Xevel/usb2ax_pro/README.md

# usb2ax_pro
Fast USB interface for robotics servos (Dynamixel)

## License
Code is under MIT License.
