Xevel/usb2ax_pro/elec/usb2ax_pro_main_v1.0.brd

## EAGLE design elec/usb2ax_pro_main_v1.0.brd (2016-09-20)

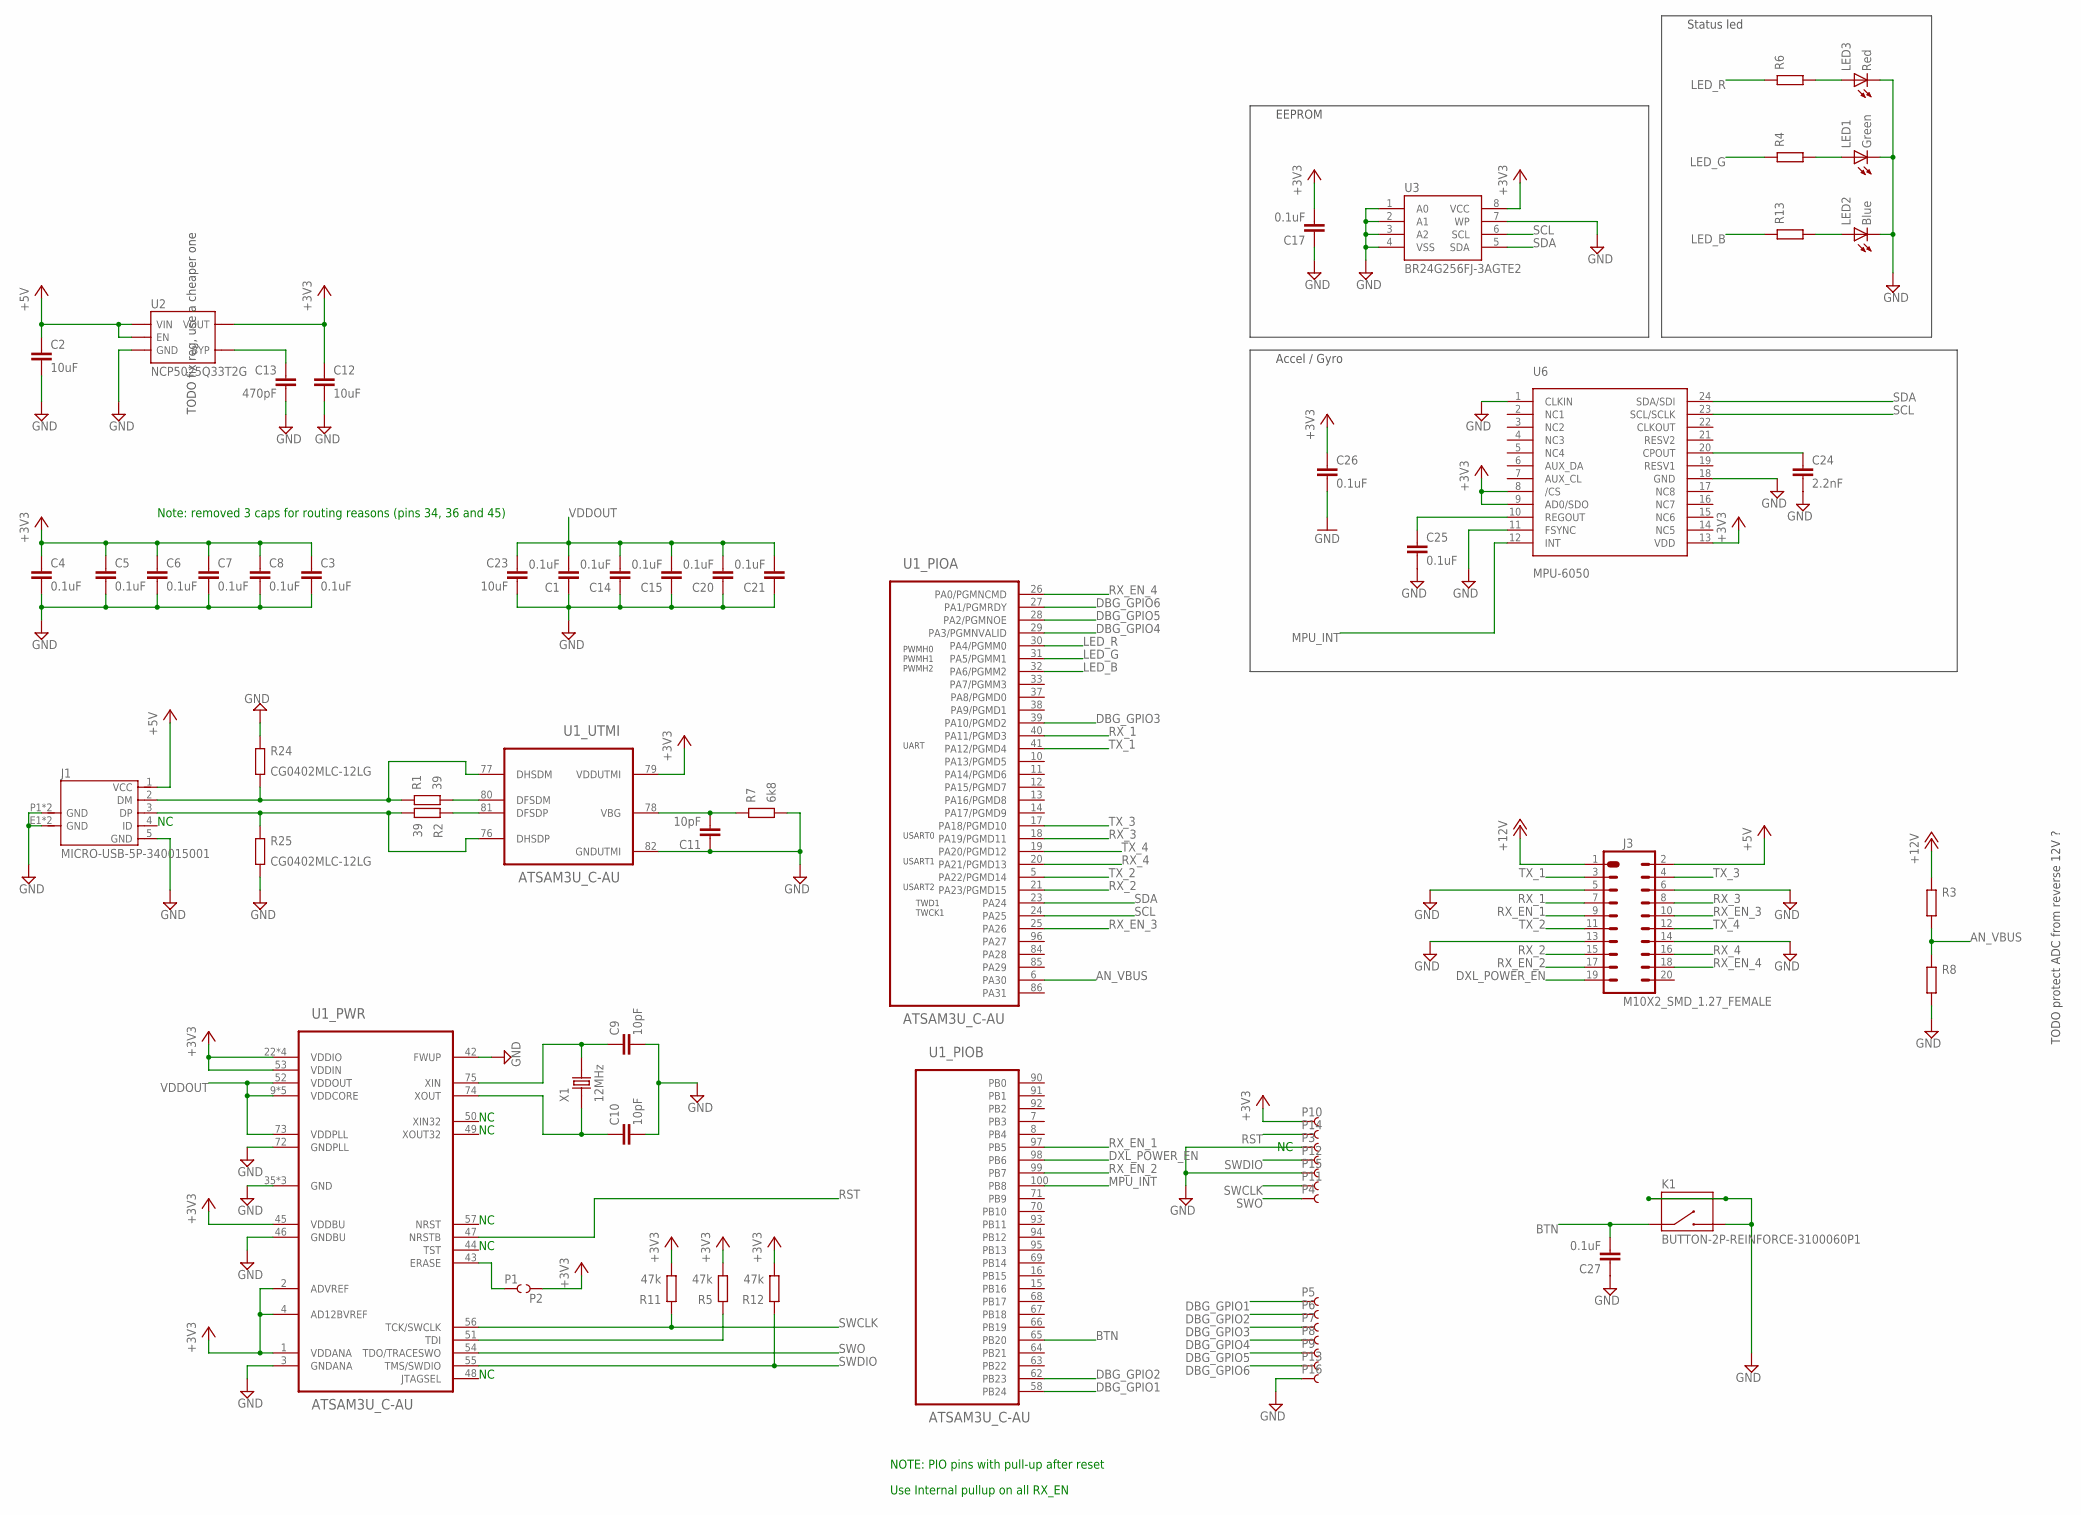
[picture p1: schematic usb2ax_pro_main_v1.0.sch]

Parts:
C1, C3, C4, C5, C6, C7, C8, C14, C15, C17, C20, C21, C25, C26, C27: 0.1uF; 0201_N
C2, C12, C23: 10uF; 0805_N
C9, C10, C11: 10pF; 0201_N
C13: 470pF; 0201_N
C24: 2.2nF; 0201_N
J1: MICRO-USB-5P-340015001; B-SMD-5P
J3: M10X2_SMD_1.27_FEMALE; 2X10_SMD_1.27_FEMALE
K1: BUTTON-2P-REINFORCE-3100060P1; 4P-SMD-7.0X3.5X3.5H-90D
LED1: Green; D_0603_N
LED2: Blue; D_0603_N
LED3: Red; D_0603_N
P1, P2: PIN_SMD_2X2.5
P3, P4, P10, P11, P12, P14, P15: PIN_SMD_0.8X1.6
P5, P6, P7, P8, P9, P13, P16: PIN_SMD_1X2
R1, R2: 39; 0201_N
R3, R4, R6, R8, R13: R0201; 0201_N
R5, R11, R12: 47k; 0201_N
R7: 6k8; 0201_N
R24, R25: CG0402MLC-12LG; 0402_N
U1: ATSAM3U_C-AU; QFP50P1600X1600-100N
U2: NCP5025Q33T2G; SC70-5
U3: BR24G256FJ-3AGTE2; SO08
U6: MPU-6050; QFN-24
X1: 12MHz; 2P-SMD-5.0X3.2

Connections:
+3V3: C3.1, C4.1, C5.1, C6.1, C7.1, C8.1, C12.1, C17.2, C26.1, P2.PIN, P10.PIN, R5.1, R11.1, R12.1, U1.1 (VDDANA), U1.2 (ADVREF), U1.4 (AD12BVREF), U1.22 (VDDIO), U1.36 (VDDIO), U1.45 (VDDBU), U1.53 (VDDIN), U1.60 (VDDIO), U1.79 (VDDUTMI), U1.88 (VDDIO), U2.5 (VOUT), U3.8 (VCC), U6.8 (/CS), U6.9 (AD0/SDO), U6.13 (VDD)
+5V: C2.1, J1.1 (VCC), J3.2, U2.1 (VIN), U2.3 (EN)
+12V: J3.1, R3.2
AN_VBUS: R3.1, R8.2, U1.6 (PA30)
BTN: C27.2, K1.1, U1.65 (PB20)
DBG_GPIO1: P5.P$1, U1.58 (PB24)
DBG_GPIO2: P6.P$1, U1.62 (PB23)
DBG_GPIO3: P7.P$1, U1.39 (PA10/PGMD2)
DBG_GPIO4: P8.P$1, U1.29 (PA3/PGMNVALID)
DBG_GPIO5: P9.P$1, U1.28 (PA2/PGMNOE)
DBG_GPIO6: P13.P$1, U1.27 (PA1/PGMRDY)
DXL_POWER_EN: J3.19, U1.98 (PB6)
GND: C1.1, C2.2, C3.2, C4.2, C5.2, C6.2, C7.2, C8.2, C9.2, C10.2, C11.1, C12.2, C13.2, C14.1, C15.1, C17.1, C20.1, C21.1, C23.2, C24.2, C25.2, C26.2, C27.1, J1.5 (GND), J1.E1 (GND), J1.E2 (GND), J1.P1 (GND), J1.P2 (GND), J3.5, J3.6, J3.13, J3.14, K1.2, K1.S1, K1.S2, LED1.C, LED2.C, LED3.C, P3.PIN, P15.PIN, P16.P$1, R7.1, R8.1, R24.2, R25.1, U1.3 (GNDANA), U1.35 (GND), U1.42 (FWUP), U1.46 (GNDBU), U1.61 (GND), U1.72 (GNDPLL), U1.82 (GNDUTMI), U1.89 (GND), U2.2 (GND), U3.1 (A0), U3.2 (A1), U3.3 (A2), U3.4 (VSS), U3.7 (WP), U6.1 (CLKIN), U6.11 (FSYNC), U6.18 (GND)
LED_B: R13.2, U1.32 (PA6/PGMM2)
LED_G: R4.2, U1.31 (PA5/PGMM1)
LED_R: R6.2, U1.30 (PA4/PGMM0)
MPU_INT: U1.100 (PB8), U6.12 (INT)
unnamed: J1.2 (DM), R1.2, R24.1, U1.77 (DHSDM)
unnamed: J1.3 (DP), R2.1, R25.2, U1.76 (DHSDP)
unnamed: R2.2, U1.81 (DFSDP)
unnamed: R1.1, U1.80 (DFSDM)
unnamed: LED3.A, R6.1
unnamed: LED2.A, R13.1
unnamed: LED1.A, R4.1
unnamed: C9.1, U1.75 (XIN), X1.2
unnamed: C10.1, U1.74 (XOUT), X1.1
unnamed: P1.PIN, U1.43 (ERASE)
unnamed: C13.1, U2.4 (BYP)
unnamed: C11.2, R7.2, U1.78 (VBG)
unnamed: C25.1, U6.10 (REGOUT)
unnamed: C24.1, U6.20 (CPOUT)
RST: P14.PIN, U1.47 (NRSTB)
RX_1: J3.7, U1.40 (PA11/PGMD3)
RX_2: J3.15, U1.21 (PA23/PGMD15)
RX_3: J3.8, U1.18 (PA19/PGMD11)
RX_4: J3.16, U1.20 (PA21/PGMD13)
RX_EN_1: J3.9, U1.97 (PB5)
RX_EN_2: J3.17, U1.99 (PB7)
RX_EN_3: J3.10, U1.25 (PA26)
RX_EN_4: J3.18, U1.26 (PA0/PGMNCMD)
SCL: U1.24 (PA25), U3.6 (SCL), U6.23 (SCL/SCLK)
SDA: U1.23 (PA24), U3.5 (SDA), U6.24 (SDA/SDI)
SWCLK: P11.PIN, R11.2, U1.56 (TCK/SWCLK)
SWDIO: P12.PIN, R12.2, U1.55 (TMS/SWDIO)
SWO: P4.PIN, U1.54 (TDO/TRACESWO)
TDI: R5.2, U1.51 (TDI)
TX_1: J3.3, U1.41 (PA12/PGMD4)
TX_2: J3.11, U1.5 (PA22/PGMD14)
TX_3: J3.4, U1.17 (PA18/PGMD10)
TX_4: J3.12, U1.19 (PA20/PGMD12)
VDDOUT: C1.2, C14.2, C15.2, C20.2, C21.2, C23.1, U1.9 (VDDCORE), U1.34 (VDDCORE), U1.52 (VDDOUT), U1.59 (VDDCORE), U1.73 (VDDPLL), U1.83 (VDDCORE), U1.87 (VDDCORE)

Notes on the sheet:
NOTE: PIO pins with pull-up after reset
Status led
Use Internal pullup on all RX_EN
EEPROM
Accel / Gyro
UART
USART0
USART1
USART2
TODO protect ADC from reverse 12V ?
Note: removed 3 caps for routing reasons (pins 34, 36 and 45)
PWMH0 PWMH1 PWMH2
TWD1 TWCK1
TODO fix reg, use a cheaper one

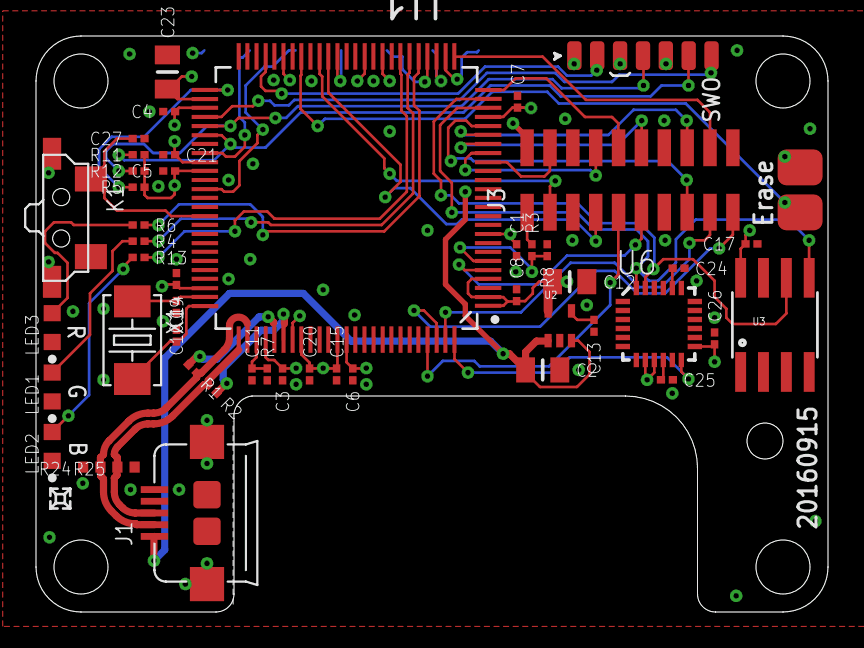
[picture p2: board usb2ax_pro_main_v1.0.brd from above]

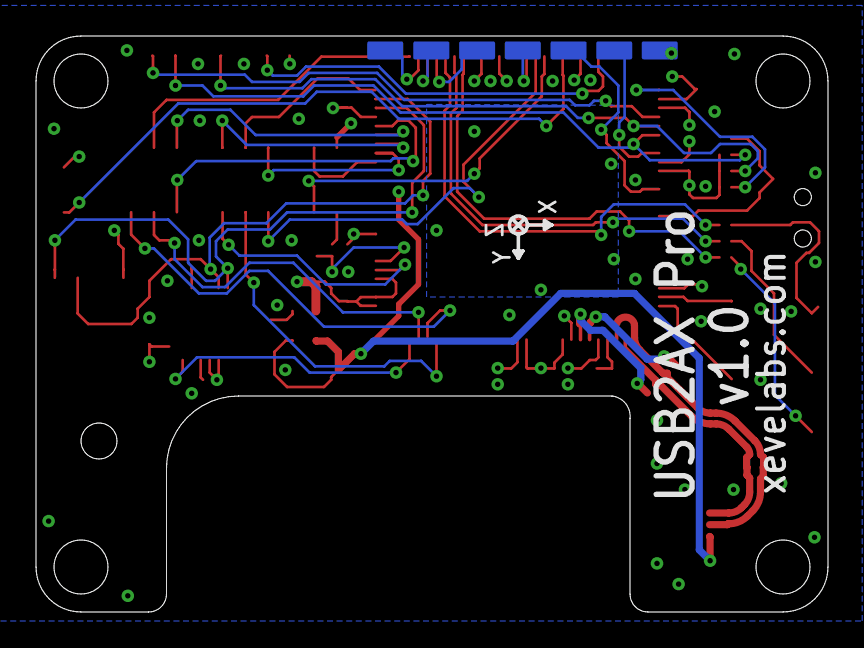
[picture p3: board usb2ax_pro_main_v1.0.brd from below]

Board: 4 copper layers, 44.0 x 32.0 mm, 64 parts (7 on the bottom side), 51 nets.

Other parts of the board:
U$3: XEVELABS_LOGO_S
