Xevel/usb2ax_pro/elec/usb2ax_pro_top_TTL_v1.0.brd

## EAGLE design elec/usb2ax_pro_top_TTL_v1.0.brd (2016-09-20)

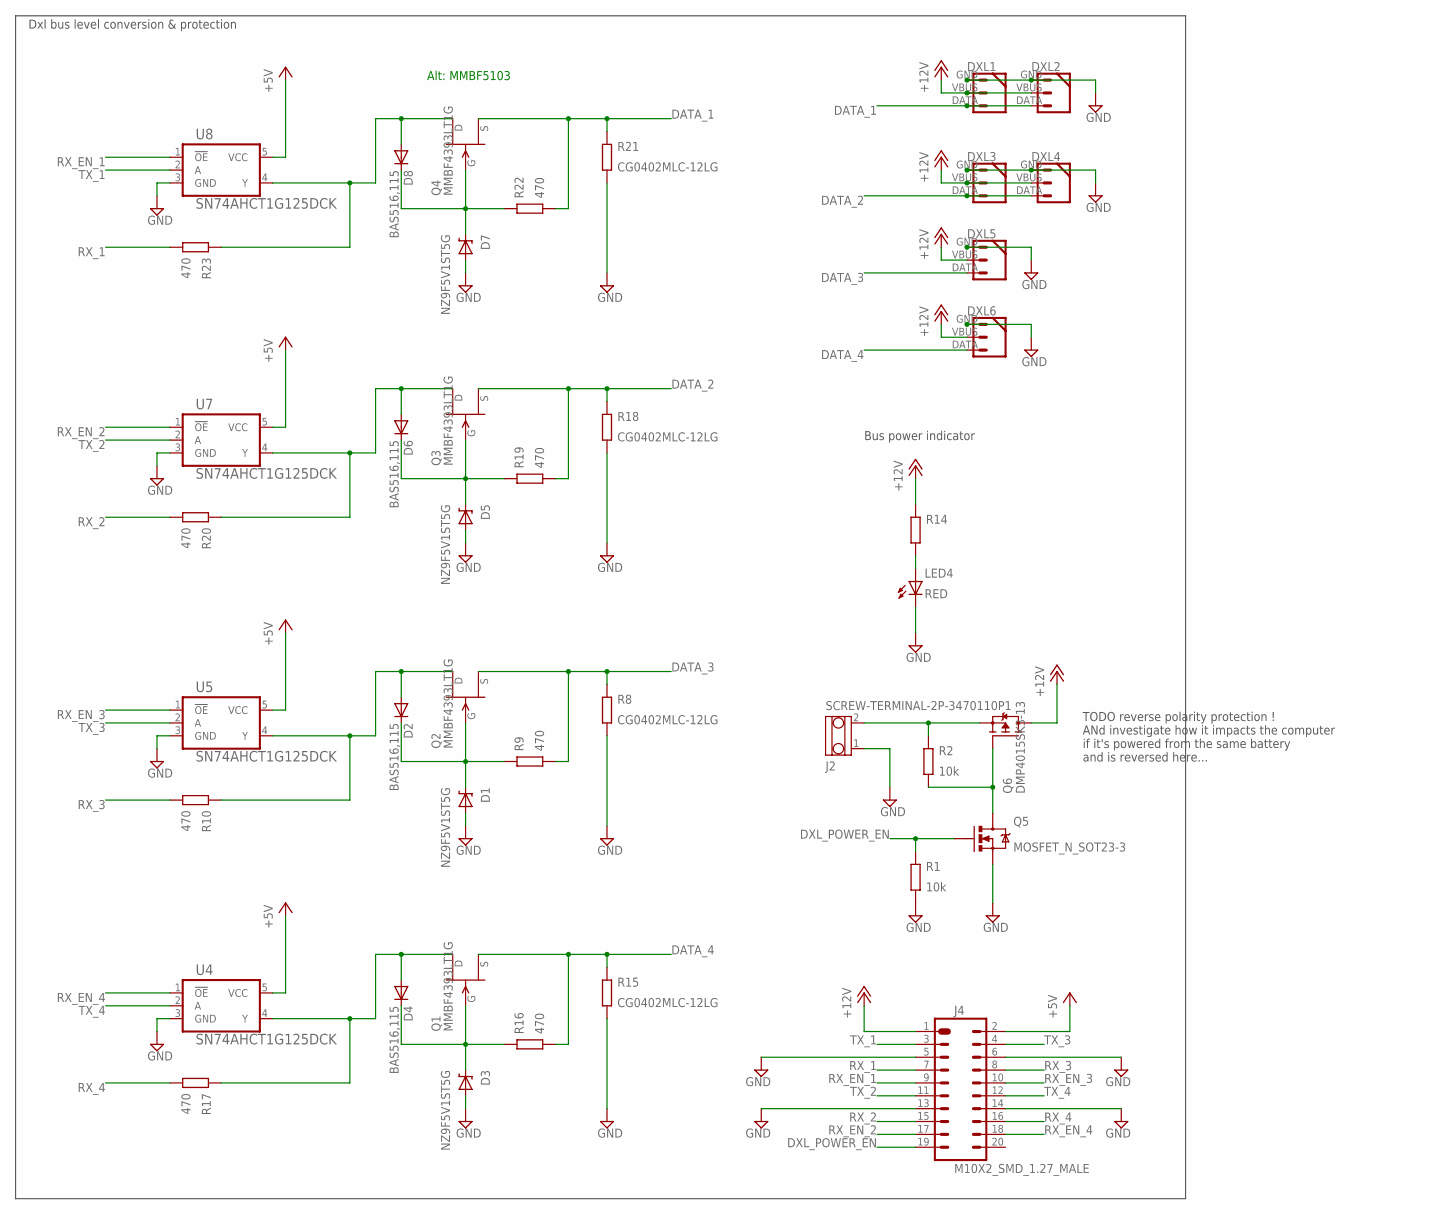
[picture p4: schematic usb2ax_pro_top_TTL_v1.0.sch]

Parts:
D1, D3, D5, D7: NZ9F5V1ST5G; SOD-923_N
D2, D4, D6, D8: BAS516,115; SOD523
DXL1, DXL2, DXL3, DXL4, DXL5, DXL6: DYNAMIXEL_3POS-R; DYNAMIXEL_3POS_RIGHT
J2: SCREW-TERMINAL-2P-3470110P1; 2P-5.0
J4: M10X2_SMD_1.27_MALE; 2X10_SMD_1.27_MALE
LED4: RED; D_0603_N
Q1, Q2, Q3, Q4: MMBF4393LT1G; SOT-23-3_L/SSOT-3_L
Q5: MOSFET_N_SOT23-3; SOT-23-3_N/SSOT-3_N
Q6: DMP4015SK3-13; TO252
R1, R2: 10k; 0402_N
R8, R15, R18, R21: CG0402MLC-12LG; 0402_N
R9, R10, R16, R17, R19, R20, R22, R23: 470; 0402_N
R14: R0402; 0402_N
U4, U5, U7, U8: SN74AHCT1G125DCK; SC70-5

Connections:
+5V: J4.2, U4.5 (VCC), U5.5 (VCC), U7.5 (VCC), U8.5 (VCC)
+12V: DXL1.VBUS (2), DXL2.VBUS (2), DXL3.VBUS (2), DXL4.VBUS (2), DXL5.VBUS (2), DXL6.VBUS (2), J4.1, Q6.3 (D), R14.2
DATA_1: DXL1.DATA (3), DXL2.DATA (3), Q4.2 (S), R21.2, R22.1
DATA_2: DXL3.DATA (3), DXL4.DATA (3), Q3.2 (S), R18.2, R19.1
DATA_3: DXL5.DATA (3), Q2.2 (S), R8.2, R9.1
DATA_4: DXL6.DATA (3), Q1.2 (S), R15.2, R16.1
DXL_POWER_EN: J4.19, Q5.1 (G), R1.2
GND: D1.A, D3.A, D5.A, D7.A, DXL1.GND (1), DXL2.GND (1), DXL3.GND (1), DXL4.GND (1), DXL5.GND (1), DXL6.GND (1), J2.1, J4.5, J4.6, J4.13, J4.14, LED4.C, Q5.2 (S), R1.1, R8.1, R15.1, R18.1, R21.1, U4.3 (GND), U5.3 (GND), U7.3 (GND), U8.3 (GND)
unnamed: Q5.3 (D), Q6.1 (G), R2.1
unnamed: D3.C, D4.C, Q1.3 (G), R16.2
unnamed: D1.C, D2.C, Q2.3 (G), R9.2
unnamed: D2.A, Q2.1 (D), R10.2, U5.4 (Y)
unnamed: LED4.A, R14.1
unnamed: D4.A, Q1.1 (D), R17.2, U4.4 (Y)
unnamed: D5.C, D6.C, Q3.3 (G), R19.2
unnamed: D6.A, Q3.1 (D), R20.2, U7.4 (Y)
unnamed: D7.C, D8.C, Q4.3 (G), R22.2
unnamed: J2.2, Q6.2 (S), R2.2
unnamed: D8.A, Q4.1 (D), R23.2, U8.4 (Y)
RX_1: J4.7, R23.1
RX_2: J4.15, R20.1
RX_3: J4.8, R10.1
RX_4: J4.16, R17.1
RX_EN_1: J4.9, U8.1 (!OE)
RX_EN_2: J4.17, U7.1 (!OE)
RX_EN_3: J4.10, U5.1 (!OE)
RX_EN_4: J4.18, U4.1 (!OE)
TX_1: J4.3, U8.2 (A)
TX_2: J4.11, U7.2 (A)
TX_3: J4.4, U5.2 (A)
TX_4: J4.12, U4.2 (A)

Notes on the sheet:
Dxl bus level conversion & protection
Alt: MMBF5103
TODO reverse polarity protection ! ANd investigate how it impacts the computer if it's powered from the same battery and is reversed here...
Bus power indicator

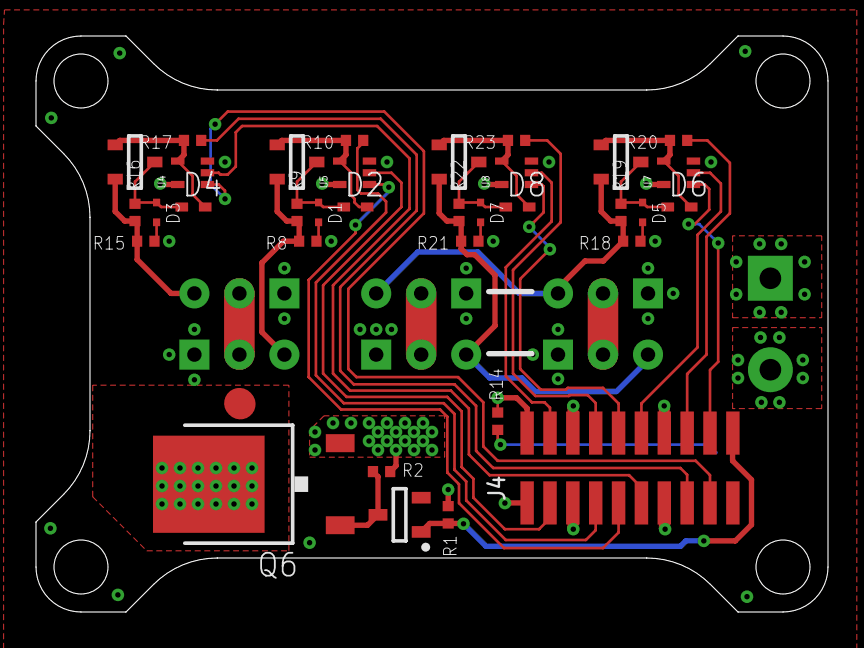
[picture p5: board usb2ax_pro_top_TTL_v1.0.brd from above]

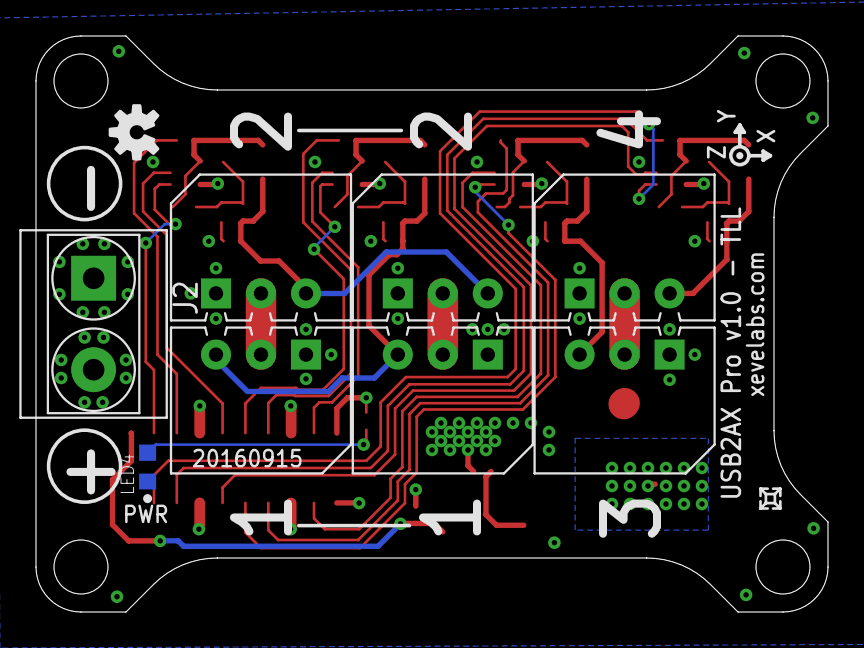
[picture p6: board usb2ax_pro_top_TTL_v1.0.brd from below]

Board: 4 copper layers, 44.0 x 32.0 mm, 44 parts (11 on the bottom side), 31 nets.

Other parts of the board:
U$1: XEVELABS_LOGO_S
U$2: OSHW-LOGO-S
