Xevel/usb2ax_pro/(commit log)

2016-09-20 First version of the boards.
    [usb2ax_pro_main_v1.0.brd, usb2ax_pro_main_v1.0.sch, usb2ax_pro_top_TTL_v1.0.brd, usb2ax_pro_top_TTL_v1.0.sch]
2016-09-20 Fixed 3V3 reg value
    [usb2ax_pro_main_v1.0.brd, usb2ax_pro_main_v1.0.sch]
